ETR69/Small-NFC-reader/CorrectMatching.jpg

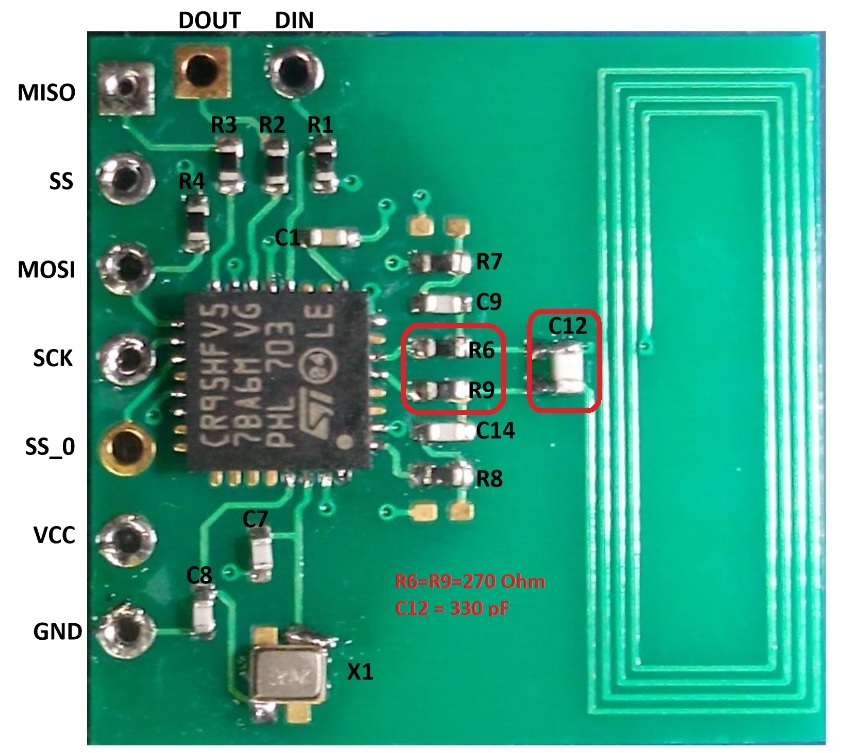
CorrectMatching.jpg
