ETR69/Small-NFC-reader/AntennaImpedance.jpg

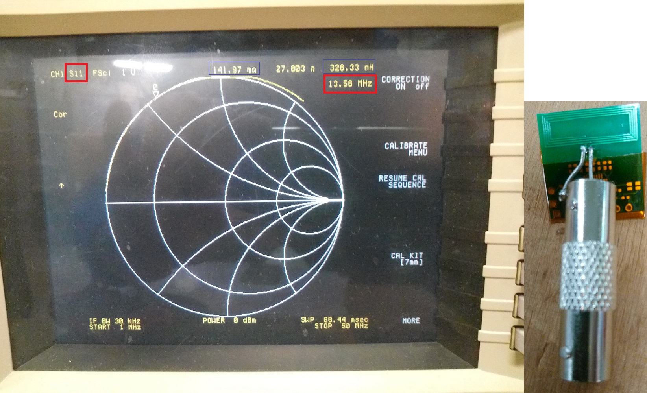
AntennaImpedance.jpg
