ETR69/Small-NFC-reader/NFC_reader.pdf

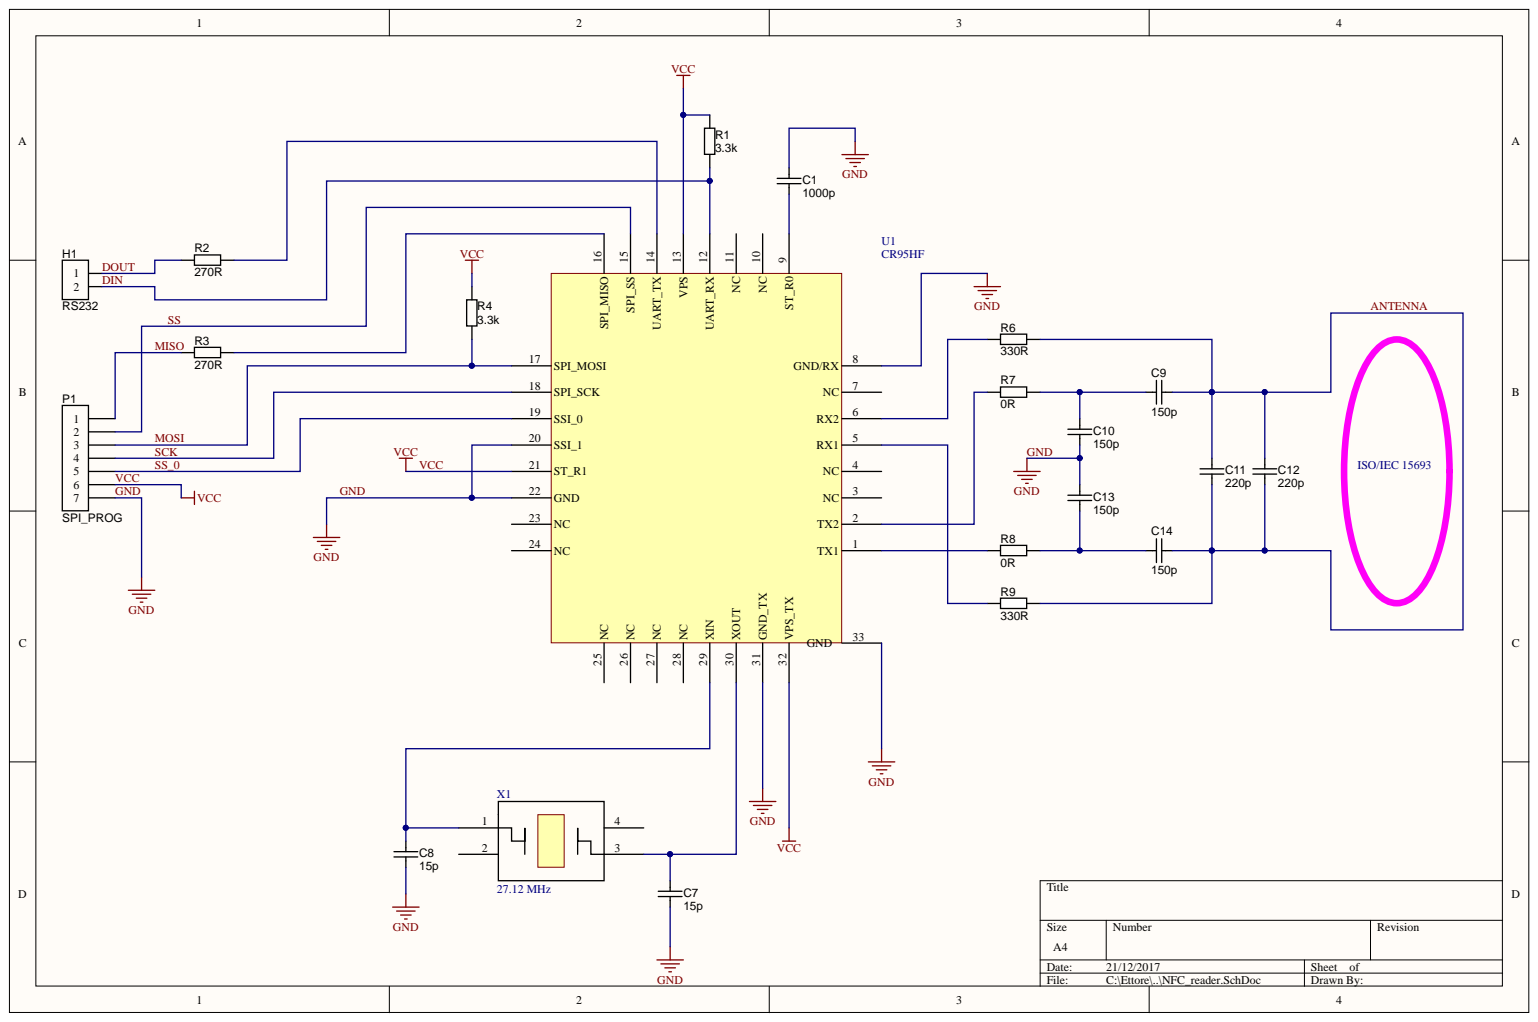
[picture p3: page 1]

SPI_SCK 18 | 7

SSI_0 19 | 6

MOSI | SSI_1 20 | 5
SCK VCC | | ST_R1 21 | 4

VCC | | GND 22 | 3
GND

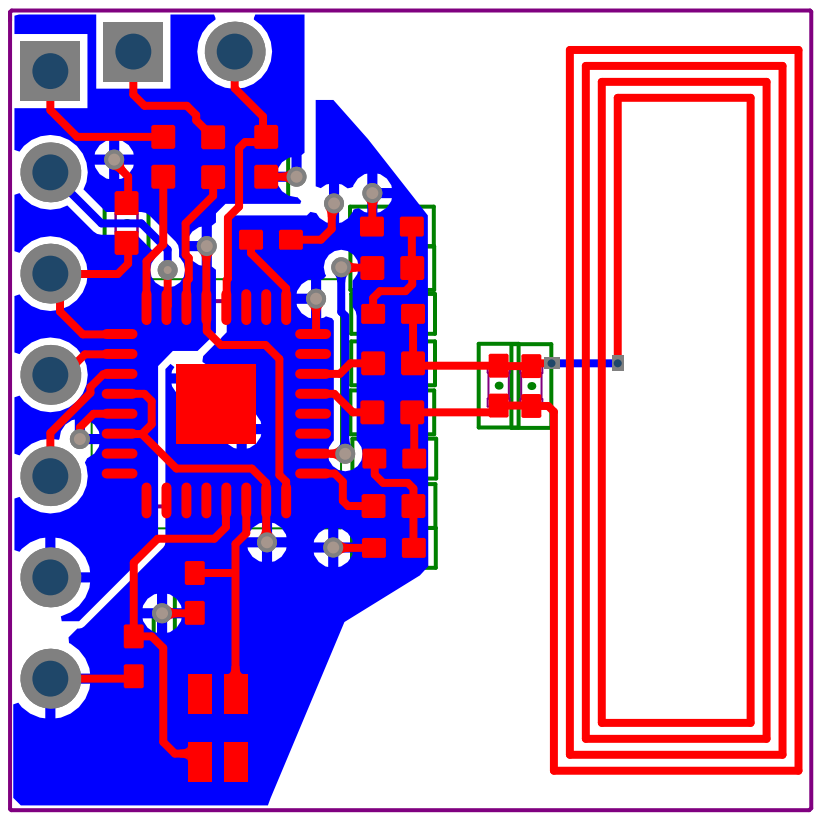
[picture p4: page 2]

# Board S
