ETR69/Small-NFC-reader/SmallNFCreader_assembly_instructions.pdf

# Small NFC reader

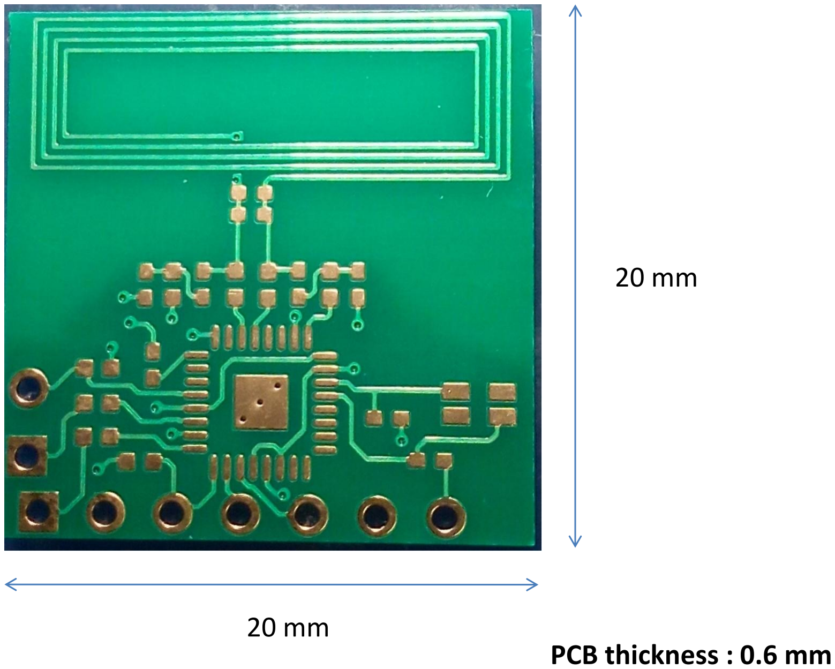
[picture p5: figure]
PCB thickness : 0.6 mm

20 mm

## Assembly instructions

ETR69

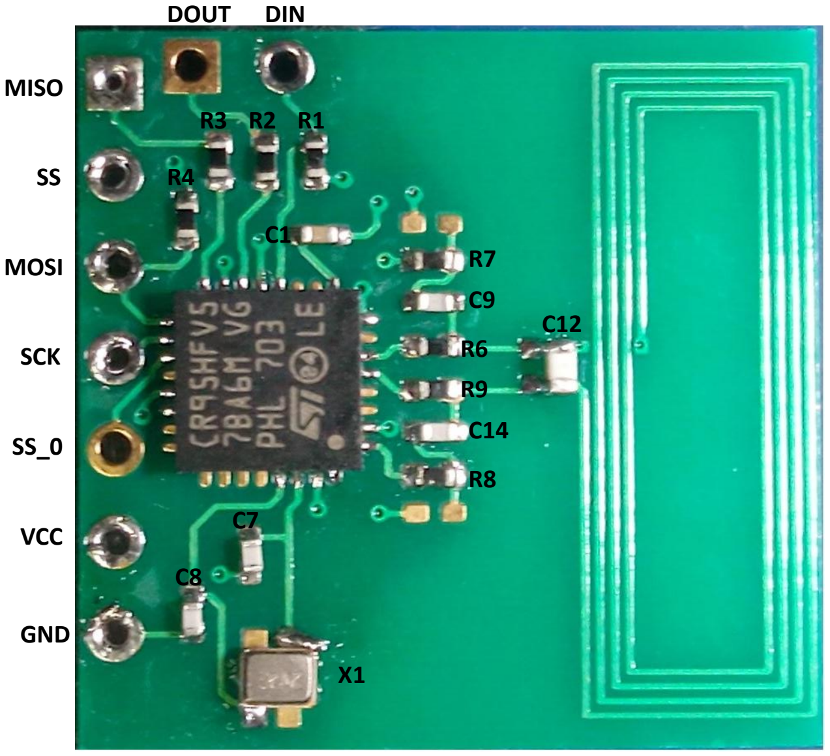
[picture p6: page 2]

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
R3 R2 R1

R4

DOUT DIN

MISO

SS

MOSI

SCK

SS_0

VCC

GND

Bill of material:

C12=330 pF Ceramic (COG/NP0) 5% 0603 or 0402
C9, C14 = 150 pF Ceramic (COG/NP0) 0402 , Code : 490-3229-1-ND C8,C7 = 15 pF Ceramic (COG/NP0) 0402 , Code : 490-3117-1-ND C1=1000 pF Ceramic (X7R) 0402 , Code : 399-1032-1-ND

R6,R9 = 270 OHM 5% 0402
R7,R8 = 0 OHM 0402 Code: 1276-3480-1-ND
R1,R4 = 3.3k OHM 5% 0402 Code: 311-3.3KJRCT-ND R2,R3 = 270 OHM 5% 0402 Code: 311-270JRCT-ND

U1 = CR95HF (32VFQFPN) Code: 497-15737-1-ND

X1= CRYSTAL 27.12 MHZ Code: 490-5581-1-ND

All codes are from Digi-Key

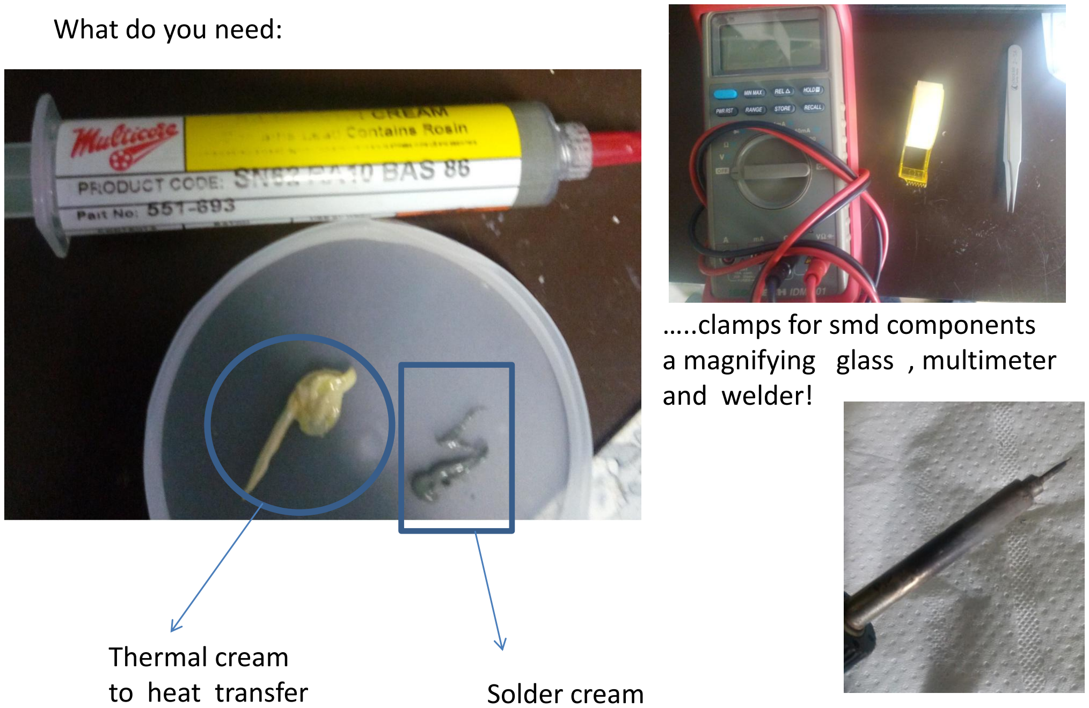
[picture p7: page 4]

Thermal cream
to heat transfer | Solder cream

What do you need:

…..clamps for smd components a magnifying glass , multimeter and welder!

First you have to solder CR95HF:

put with a toothpick the thermal cream on the central pad of the chip:

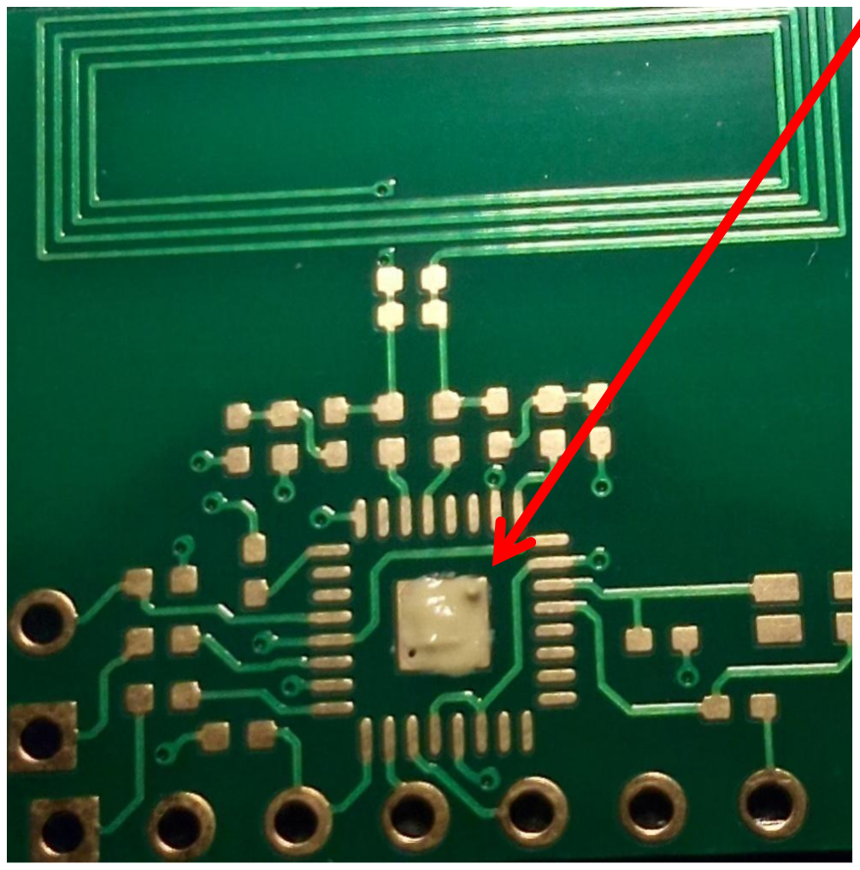
[picture p8: figure]

Then you can aligne CR95HF with pcb pad. Check each chip side!
Thermal paste prevents the chip from falling or moving too much during the alignment

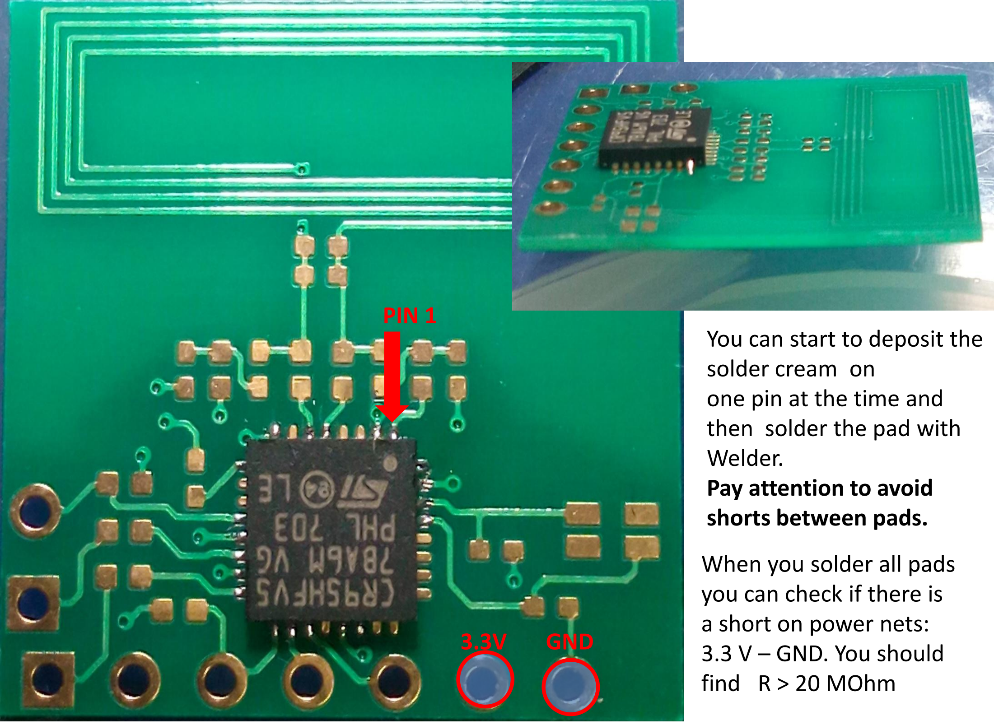
[picture p9: page 6]

PIN 1
You can start to deposit the solder cream on
one pin at the time and
then solder the pad with
Welder.
Pay attention to avoid
shorts between pads.

When you solder all pads
you can check if there is
a short on power nets:
3.3 V – GND. You should
find R > 20 MOhm

3.3V GND

You can now solder crystal and all passive components like in picture:

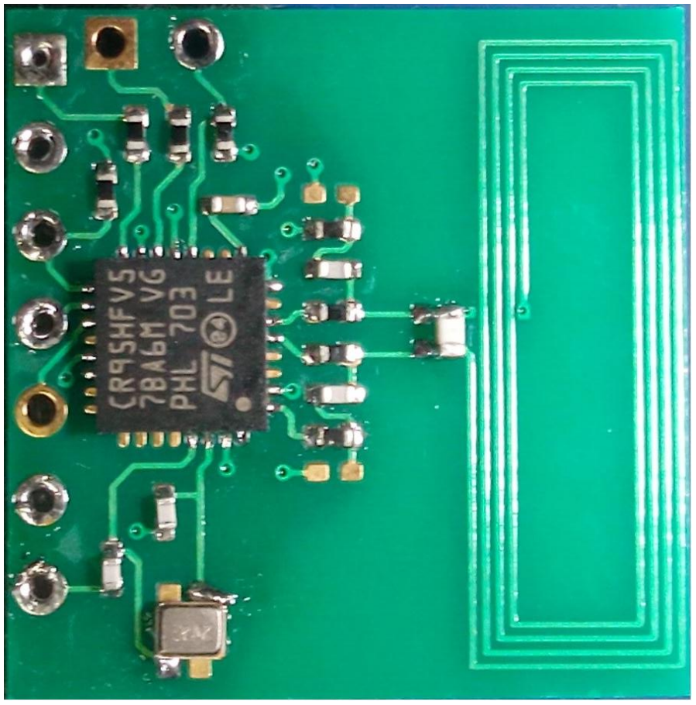
[picture p10: figure]
